kiritsugusioe-max/component-identifier-circuit-with-capacitance-measurement/image/Circuit.jpeg

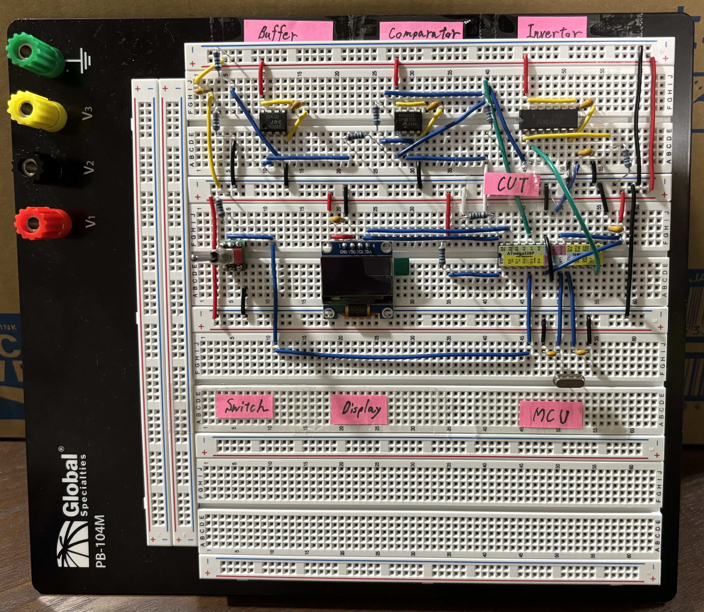
image/Circuit.jpeg
