kiritsugusioe-max/component-identifier-circuit-with-capacitance-measurement/data/Section4.1_4.2_Measurement_Data.xlsx

OPEN |  |  |  |  |  |  | Resistor | R=10kΩ |  |  |  |  |  | Resistor | R=4.7kΩ |  |  |  |  |  | Resistor | R=1kΩ
Buffer Output Voltage |  |  |  |  |  |  | Buffer Output Voltage |  |  |  |  |  |  | Buffer Output Voltage |  |  |  |  |  |  | Buffer Output Voltage
 | 1st | 2nd | 3rd | 4th | 5th | Ave |  | 1st | 2nd | 3rd | 4th | 5th | Ave |  | 1st | 2nd | 3rd | 4th | 5th | Ave |  | 1st | 2nd | 3rd | 4th | 5th | Ave
Max | 3.02 | 3.02 | 3.02 | 3.04 | 3.04 | 3.03 | Max | 3.04 | 3.02 | 3.02 | 3.02 | 3.02 | 3.02 | Max | 3.04 | 3.04 | 3.04 | 3.04 | 3.04 | 3.04 | Max | 3.03 | 3.03 | 3.03 | 3.03 | 3.03 | 3.03
Min | 2.96 | 2.96 | 2.96 | 2.92 | 2.94 | 2.95 | Min | 2.94 | 2.96 | 2.96 | 2.96 | 2.96 | 2.96 | Min | 2.8 | 2.8 | 2.8 | 2.8 | 2.8 | 2.8 | Min | 2.79 | 2.87 | 2.79 | 2.79 | 2.79 | 2.81
Ave | 2.98 | 2.98 | 2.98 | 2.98 | 2.98 | 2.98 | Ave | 2.99 | 2.99 | 2.99 | 2.99 | 2.99 | 2.99 | Ave | 2.92 | 2.92 | 2.92 | 2.92 | 2.92 | 2.92 | Ave | 2.94 | 2.94 | 2.94 | 2.94 | 2.94 | 2.94
(V) |  |  |  |  |  |  | (V) |  |  |  |  |  |  | (V) |  |  |  |  |  |  | (V)
V+ |  |  |  |  |  |  | V+ |  |  |  |  |  |  | V+ |  |  |  |  |  |  | V+
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
