kiritsugusioe-max/component-identifier-circuit-with-capacitance-measurement/data/Section4.3_Measurement_Data.xlsx

C=10nF |  |  |  |  |  |  |  |  |  |  |  |  |  |  |  |  |  |  |  |  | Circuit-Level Measurement |  |  |  |  |  |  | Circuit-Level Measurement
1st Trial |  |  |  |  |  |  | 2nd Trial |  |  |  |  |  |  | 3rd Trial |  |  |  |  |  |  | 10 nF Capacitance Measurement Summary |  |  |  |  |  |  | Capacitance Measurement Summary for Determining K
Measured Capacitance |  |  |  |  |  |  | Measured Capacitance |  |  |  |  |  |  | Measured Capacitance |  |  |  |  |  |  | Trial | Comparator Output Voltage VH |  | Comparator Output Voltage VL |  | VT+ at V- | VT- at V- | Comparator Output Voltage VH |  | Comparator Output Voltage VL |  | VT+ at V- | VT- at V-
 | 1st | 2nd | 3rd | 4th | 5th | Ave |  | 1st | 2nd | 3rd | 4th | 5th | Ave |  | 1st | 2nd | 3rd | 4th | 5th | Ave | 1 |  | 4.936 |  | 0.015 | 3.97 | 1.48 |  | 4.94 |  | 0.019 | 3.99 | 1.46
C | 10.97 | 11.16 | 11.1 | 10.73 | 11.04 | 11 | C | 10.89 | 10.9 | 10.81 | 10.8 | 10.76 | 10.83 | C | 10.85 | 10.79 | 10.98 | 10.73 | 10.65 | 10.8 | 2 |  | 4.94 |  | 0.012 | 3.98 | 1.48 |  | (V) |  | (V) | (V) | (V)
(nF) |  |  |  |  |  |  | (nF) |  |  |  |  |  |  | (nF) |  |  |  |  |  |  | 3 |  | 4.94 |  | 0.011 | 3.98 | 1.48
 |  |  |  |  |  |  |  |  |  |  |  |  |  |  |  |  |  |  |  |  | Average |  | 4.939 |  | 0.01267 | 3.977 | 1.48
Measured Resistance |  |  |  |  |  |  | Measured Resistance |  |  |  |  |  |  | Measured Resistance |  |  |  |  |  |  | Unit |  | (V) |  | (V) | (V) | (V)
 | 1st | 2nd | 3rd | 4th | 5th | Ave |  | 1st | 2nd | 3rd | 4th | 5th | Ave |  | 1st | 2nd | 3rd | 4th | 5th | Ave
R | 9.985 | 9.985 | 9.985 | 9.985 | 9.985 | 9.985 | R | 9.985 | 9.985 | 9.985 | 9.985 | 9.985 | 9.985 | R | 9.986 | 9.985 | 9.985 | 9.985 | 9.985 | 9.985
(kΩ) |  |  |  |  |  |  | (kΩ) |  |  |  |  |  |  | (kΩ)
Comparator Output Voltage |  |  |  |  |  |  | Comparator Output Voltage |  |  |  |  |  |  | Comparator Output Voltage
 | 1st | 2nd | 3rd | 4th | 5th | Ave |  | 1st | 2nd | 3rd | 4th | 5th | Ave |  | 1st | 2nd | 3rd | 4th | 5th | Ave
V_HIGH | 4.93 | 4.94 | 4.94 | 4.94 | 4.93 | 4.936 | V_HIGH | 4.94 | 4.94 | 4.94 | 4.94 | 4.94 | 4.94 | V_HIGH | 4.94 | 4.94 | 4.94 | 4.94 | 4.94 | 4.94
V_LOW | 0.014 | 0.016 | 0.016 | 0.015 | 0.015 | 0.015 | V_LOW | 0.013 | 0.011 | 0.012 | 0.012 | 0.012 | 0.012 | V_LOW | 0.011 | 0.011 | 0.011 | 0.011 | 0.01 | 0.011
(V) |  |  |  |  |  |  | (V) |  |  |  |  |  |  | (V)
V+ |  |  |  |  |  |  | V+ |  |  |  |  |  |  | V+
 | 1st | 2nd | 3rd | 4th | 5th | Ave |  | 1st | 2nd | 3rd | 4th | 5th | Ave |  | 1st | 2nd | 3rd | 4th | 5th | Ave
Threshold_H | 3.95 | 3.95 | 3.96 | 3.95 | 3.95 | 3.952 | Threshold_H | 3.96 | 3.96 | 3.96 | 3.96 | 3.96 | 3.96 | Threshold_H | 3.96 | 3.96 | 3.96 | 3.96 | 3.96 | 3.96
Threshold_L | 1.5 | 1.5 | 1.5 | 1.5 | 1.5 | 1.5 | Threshold_L | 1.5 | 1.5 | 1.5 | 1.5 | 1.5 | 1.5 | Threshold_L | 1.5 | 1.5 | 1.5 | 1.5 | 1.5 | 1.5
(V) |  |  |  |  |  |  | (V) |  |  |  |  |  |  | (V)
V- |  |  |  |  |  |  | V- |  |  |  |  |  |  | V-
 | 1st | 2nd | 3rd | 4th | 5th | Ave |  | 1st | 2nd | 3rd | 4th | 5th | Ave |  | 1st | 2nd | 3rd | 4th | 5th | Ave
Threshold_H | 3.97 | 3.97 | 3.97 | 3.97 | 3.97 | 3.97 | Threshold_H | 3.98 | 3.98 | 3.98 | 3.98 | 3.98 | 3.98 | Threshold_H | 3.98 | 3.98 | 3.98 | 3.98 | 3.98 | 3.98
Threshold_L | 1.48 | 1.48 | 1.48 | 1.48 | 1.48 | 1.48 | Threshold_L | 1.48 | 1.48 | 1.48 | 1.48 | 1.48 | 1.48 | Threshold_L | 1.48 | 1.49 | 1.48 | 1.48 | 1.49 | 1.48
(V) |  |  |  |  |  |  | (V) |  |  |  |  |  |  | (V)
Recalculated Period & Capacitance (based on measured values) |  |  |  |  |  |  | Recalculated Period & Capacitance (based on measured values) |  |  |  |  |  |  | Recalculated Period & Capacitance (based on measured values)
T_calibrated | 249 | (us) |  |  |  |  | T_calibrated | 246 | (us) |  |  |  |  | T_calibrated | 245 | (us)
C_calibrated | 10.8 | (nF) |  |  |  |  | C_calibrated | 10.83 | (nF) |  |  |  |  | C_calibrated | 11 | (nF)
C=4.7nF |  |  |  |  |  |  |  |  |  |  |  |  |  |  |  |  |  |  |  |  | Circuit-Level Measurement
1st Trial |  |  |  |  |  |  | 2nd Trial |  |  |  |  |  |  | 3rd Trial |  |  |  |  |  |  | 4.7nF Capacitance Measurement Summary
Measured Capacitance |  |  |  |  |  |  | Measured Capacitance |  |  |  |  |  |  | Measured Capacitance |  |  |  |  |  |  | Trial | Comparator Output Voltage VH |  | Comparator Output Voltage VL |  | VT+ at V- | VT- at V-
 | 1st | 2nd | 3rd | 4th | 5th | Ave |  | 1st | 2nd | 3rd | 4th | 5th | Ave |  | 1st | 2nd | 3rd | 4th | 5th | Ave | 1 |  | 4.938 |  | 0.019 | 3.98 | 1.476
C | 4.561 | 4.574 | 4.588 | 4.579 | 4.577 | 4.5758 | C | 4.601 | 4.639 | 4.653 | 4.657 | 4.653 | 4.6406 | C | 4.592 | 4.594 | 4.607 | 4.624 | 4.612 | 4.6058 | 2 |  | 4.92 |  | 0.021 | 3.98 | 1.47
(nF) |  |  |  |  |  |  | (nF) |  |  |  |  |  |  | (nF) |  |  |  |  |  |  | 3 |  | 4.94 |  | 0.018 | 3.98 | 1.47
 |  |  |  |  |  |  |  |  |  |  |  |  |  |  |  |  |  |  |  |  | Average |  | 4.933 |  | 0.01933 | 3.98 | 1.472
Measured Resistance |  |  |  |  |  |  | Measured Resistance |  |  |  |  |  |  | Measured Resistance |  |  |  |  |  |  | Unit |  | (V) |  | (V) | (V) | (V)
 | 1st | 2nd | 3rd | 4th | 5th | Ave |  | 1st | 2nd | 3rd | 4th | 5th | Ave |  | 1st | 2nd | 3rd | 4th | 5th | Ave
R | 9.985 | 9.985 | 9.985 | 9.985 | 9.985 | 9.985 | R | 9.985 | 9.985 | 9.985 | 9.985 | 9.985 | 9.985 | R | 9.985 | 9.985 | 9.985 | 9.985 | 9.985 | 9.985
(kΩ) |  |  |  |  |  |  | (kΩ) |  |  |  |  |  |  | (kΩ)
Comparator Output Voltage |  |  |  |  |  |  | Comparator Output Voltage |  |  |  |  |  |  | Comparator Output Voltage
 | 1st | 2nd | 3rd | 4th | 5th | Ave |  | 1st | 2nd | 3rd | 4th | 5th | Ave |  | 1st | 2nd | 3rd | 4th | 5th | Ave
V_HIGH | 4.94 | 4.93 | 4.94 | 4.94 | 4.94 | 4.938 | V_HIGH | 4.92 | 4.92 | 4.92 | 4.92 | 4.92 | 4.92 | V_HIGH | 4.94 | 4.94 | 4.94 | 4.94 | 4.94 | 4.94
V_LOW | 0.02 | 0.02 | 0.019 | 0.017 | 0.018 | 0.019 | V_LOW | 0.021 | 0.019 | 0.02 | 0.022 | 0.021 | 0.021 | V_LOW | 0.019 | 0.018 | 0.018 | 0.019 | 0.018 | 0.018
(V) |  |  |  |  |  |  | (V) |  |  |  |  |  |  | (V)
V+ |  |  |  |  |  |  | V+ |  |  |  |  |  |  | V+
 | 1st | 2nd | 3rd | 4th | 5th | Ave |  | 1st | 2nd | 3rd | 4th | 5th | Ave |  | 1st | 2nd | 3rd | 4th | 5th | Ave
Threshold_H | 3.96 | 3.96 | 3.96 | 3.96 | 3.96 | 3.96 | Threshold_H | 3.95 | 3.95 | 3.95 | 3.95 | 3.95 | 3.95 | Threshold_H | 3.95 | 3.96 | 3.95 | 3.95 | 3.96 | 3.954
Threshold_L | 1.5 | 1.5 | 1.5 | 1.5 | 1.5 | 1.5 | Threshold_L | 1.5 | 1.5 | 1.5 | 1.5 | 1.5 | 1.5 | Threshold_L | 1.5 | 1.5 | 1.5 | 1.5 | 1.5 | 1.5
(V) |  |  |  |  |  |  | (V) |  |  |  |  |  |  | (V)
V- |  |  |  |  |  |  | V- |  |  |  |  |  |  | V-
 | 1st | 2nd | 3rd | 4th | 5th | Ave |  | 1st | 2nd | 3rd | 4th | 5th | Ave |  | 1st | 2nd | 3rd | 4th | 5th | Ave
Threshold_H | 3.98 | 3.98 | 3.98 | 3.98 | 3.98 | 3.98 | Threshold_H | 3.98 | 3.98 | 3.98 | 3.98 | 3.98 | 3.98 | Threshold_H | 3.98 | 3.98 | 3.98 | 3.98 | 3.98 | 3.98
Threshold_L | 1.47 | 1.47 | 1.48 | 1.48 | 1.48 | 1.476 | Threshold_L | 1.47 | 1.47 | 1.47 | 1.47 | 1.47 | 1.47 | Threshold_L | 1.47 | 1.47 | 1.47 | 1.47 | 1.47 | 1.47
(V) |  |  |  |  |  |  | (V) |  |  |  |  |  |  | (V)
Recalculated Period & Capacitance (based on measured values) |  |  |  |  |  |  | Recalculated Period & Capacitance (based on measured values) |  |  |  |  |  |  | Recalculated Period & Capacitance (based on measured values)
T_calibrated | 104 | (us) |  |  |  |  | T_calibrated | 107 | (us) |  |  |  |  | T_calibrated | 105 | (us)
C_calibrated | 4.58 | (nF) |  |  |  |  | C_calibrated | 4.64 | (nF) |  |  |  |  | C_calibrated | 4.61 | (nF)
C=2.2nF |  |  |  |  |  |  |  |  |  |  |  |  |  |  |  |  |  |  |  |  | Circuit-Level Measurement
1st Trial |  |  |  |  |  |  | 2nd Trial |  |  |  |  |  |  | 3rd Trial |  |  |  |  |  |  | 2.2nF Capacitance Measurement Summary
Measured Capacitance |  |  |  |  |  |  | Measured Capacitance |  |  |  |  |  |  | Measured Capacitance |  |  |  |  |  |  | Trial | Comparator Output Voltage VH |  | Comparator Output Voltage VL |  | VT+ at V- | VT- at V-
 | 1st | 2nd | 3rd | 4th | 5th | Ave |  | 1st | 2nd | 3rd | 4th | 5th | Ave |  | 1st | 2nd | 3rd | 4th | 5th | Ave | 1 |  | 4.93 |  | 0.028 | 3.99 | 1.46
C | 2.072 | 2.069 | 2.07 | 2.072 | 2.075 | 2.0716 | C | 2.064 | 2.068 | 2.072 | 2.078 | 2.074 | 2.0712 | C | 2.077 | 2.078 | 2.076 | 2.074 | 2.074 | 2.0758 | 2 |  | 4.934 |  | 0.024 | 3.99 | 1.46
(nF) |  |  |  |  |  |  | (nF) |  |  |  |  |  |  | (nF) |  |  |  |  |  |  | 3 |  | 4.94 |  | 0.0202 | 4 | 1.46
 |  |  |  |  |  |  |  |  |  |  |  |  |  |  |  |  |  |  |  |  | Average |  | 4.935 |  | 0.02407 | 3.993 | 1.46
Measured Resistance |  |  |  |  |  |  | Measured Resistance |  |  |  |  |  |  | Measured Resistance |  |  |  |  |  |  | Unit |  | (V) |  | (V) | (V) | (V)
 | 1st | 2nd | 3rd | 4th | 5th | Ave |  | 1st | 2nd | 3rd | 4th | 5th | Ave |  | 1st | 2nd | 3rd | 4th | 5th | Ave
R | 9.985 | 9.985 | 9.985 | 9.985 | 9.985 | 9.985 | R | 9.985 | 9.985 | 9.985 | 9.985 | 9.985 | 9.985 | R | 9.985 | 9.985 | 9.985 | 9.985 | 9.985 | 9.985
(kΩ) |  |  |  |  |  |  | (kΩ) |  |  |  |  |  |  | (kΩ)
Comparator Output Voltage |  |  |  |  |  |  | Comparator Output Voltage |  |  |  |  |  |  | Comparator Output Voltage
 | 1st | 2nd | 3rd | 4th | 5th | Ave |  | 1st | 2nd | 3rd | 4th | 5th | Ave |  | 1st | 2nd | 3rd | 4th | 5th | Ave
V_HIGH | 4.93 | 4.93 | 4.93 | 4.93 | 4.93 | 4.93 | V_HIGH | 4.94 | 4.94 | 4.93 | 4.93 | 4.93 | 4.934 | V_HIGH | 4.94 | 4.94 | 4.94 | 4.94 | 4.94 | 4.94
V_LOW | 0.028 | 0.028 | 0.028 | 0.028 | 0.027 | 0.028 | V_LOW | 0.025 | 0.024 | 0.024 | 0.024 | 0.023 | 0.024 | V_LOW | 0.019 | 0.019 | 0.019 | 0.023 | 0.021 | 0.02
(V) |  |  |  |  |  |  | (V) |  |  |  |  |  |  | (V)
V+ |  |  |  |  |  |  | V+ |  |  |  |  |  |  | V+
 | 1st | 2nd | 3rd | 4th | 5th | Ave |  | 1st | 2nd | 3rd | 4th | 5th | Ave |  | 1st | 2nd | 3rd | 4th | 5th | Ave
Threshold_H | 3.95 | 3.95 | 3.95 | 3.95 | 3.95 | 3.95 | Threshold_H | 3.96 | 3.96 | 3.96 | 3.96 | 3.96 | 3.96 | Threshold_H | 3.95 | 3.95 | 3.95 | 3.95 | 3.95 | 3.95
Threshold_L | 1.5 | 1.5 | 1.5 | 1.5 | 1.5 | 1.5 | Threshold_L | 1.5 | 1.5 | 1.5 | 1.5 | 1.5 | 1.5 | Threshold_L | 1.5 | 1.5 | 1.5 | 1.5 | 1.5 | 1.5
(V) |  |  |  |  |  |  | (V) |  |  |  |  |  |  | (V)
V- |  |  |  |  |  |  | V- |  |  |  |  |  |  | V-
 | 1st | 2nd | 3rd | 4th | 5th | Ave |  | 1st | 2nd | 3rd | 4th | 5th | Ave |  | 1st | 2nd | 3rd | 4th | 5th | Ave
Threshold_H | 3.99 | 3.99 | 3.99 | 3.99 | 3.99 | 3.99 | Threshold_H | 3.99 | 3.99 | 3.99 | 3.99 | 3.99 | 3.99 | Threshold_H | 4 | 4 | 4 | 4 | 4 | 4
Threshold_L | 1.46 | 1.46 | 1.46 | 1.46 | 1.46 | 1.46 | Threshold_L | 1.46 | 1.46 | 1.46 | 1.46 | 1.46 | 1.46 | Threshold_L | 1.46 | 1.46 | 1.46 | 1.46 | 1.46 | 1.46
(V) |  |  |  |  |  |  | (V) |  |  |  |  |  |  | (V)
Recalculated Period & Capacitance (based on measured values) |  |  |  |  |  |  | Recalculated Period & Capacitance (based on measured values) |  |  |  |  |  |  | Recalculated Period & Capacitance (based on measured values)
T_calibrated | 48.07 | (us) |  |  |  |  | T_calibrated | 47.96 | (us) |  |  |  |  | T_calibrated | 48.2 | (us)
C_calibrated | 2.09 | (nF) |  |  |  |  | C_calibrated | 2.07 | (nF) |  |  |  |  | C_calibrated | 2.08 | (nF)
C=1nF |  |  |  |  |  |  |  |  |  |  |  |  |  |  |  |  |  |  |  |  | Circuit-Level Measurement
1st Trial |  |  |  |  |  |  | 2nd Trial |  |  |  |  |  |  | 3rd Trial |  |  |  |  |  |  | 1nF Capacitance Measurement Summary
Measured Capacitance |  |  |  |  |  |  | Measured Capacitance |  |  |  |  |  |  | Measured Capacitance |  |  |  |  |  |  | Trial | Comparator Output Voltage VH |  | Comparator Output Voltage VL |  | VT+ at V- | VT- at V-
 | 1st | 2nd | 3rd | 4th | 5th | Ave |  | 1st | 2nd | 3rd | 4th | 5th | Ave |  | 1st | 2nd | 3rd | 4th | 5th | Ave | 1 |  | 4.93 |  | 0.023 | 4.01 | 1.44
C | 1.022 | 1.02 | 1.019 | 1.022 | 1.022 | 1.021 | C | 1.023 | 1.026 | 1.025 | 1.025 | 1.028 | 1.0254 | C | 1.027 | 1.027 | 1.026 | 1.025 | 1.025 | 1.026 | 2 |  | 4.946 |  | 0.027 | 4.01 | 1.44
(nF) |  |  |  |  |  |  | (nF) |  |  |  |  |  |  | (nF) |  |  |  |  |  |  | 3 |  | 4.94 |  | 0.033 | 4.01 | 1.44
 |  |  |  |  |  |  |  |  |  |  |  |  |  |  |  |  |  |  |  |  | Average |  | 4.939 |  | 0.02767 | 4.01 | 1.44
Measured Resistance |  |  |  |  |  |  | Measured Resistance |  |  |  |  |  |  | Measured Resistance |  |  |  |  |  |  | Unit |  | (V) |  | (V) | (V) | (V)
 | 1st | 2nd | 3rd | 4th | 5th | Ave |  | 1st | 2nd | 3rd | 4th | 5th | Ave |  | 1st | 2nd | 3rd | 4th | 5th | Ave
R | 9.985 | 9.985 | 9.985 | 9.985 | 9.985 | 9.985 | R | 9.985 | 9.985 | 9.985 | 9.985 | 9.985 | 9.985 | R | 9.985 | 9.985 | 9.985 | 9.985 | 9.985 | 9.985
(kΩ) |  |  |  |  |  |  | (kΩ) |  |  |  |  |  |  | (kΩ)
Comparator Output Voltage |  |  |  |  |  |  | Comparator Output Voltage |  |  |  |  |  |  | Comparator Output Voltage
 | 1st | 2nd | 3rd | 4th | 5th | Ave |  | 1st | 2nd | 3rd | 4th | 5th | Ave |  | 1st | 2nd | 3rd | 4th | 5th | Ave
V_HIGH | 4.93 | 4.93 | 4.93 | 4.93 | 4.93 | 4.93 | V_HIGH | 4.94 | 4.94 | 4.95 | 4.95 | 4.95 | 4.946 | V_HIGH | 4.94 | 4.94 | 4.94 | 4.94 | 4.94 | 4.94
V_LOW | 0.023 | 0.024 | 0.023 | 0.023 | 0.024 | 0.023 | V_LOW | 0.026 | 0.026 | 0.028 | 0.027 | 0.027 | 0.027 | V_LOW | 0.033 | 0.033 | 0.034 | 0.033 | 0.034 | 0.033
(V) |  |  |  |  |  |  | (V) |  |  |  |  |  |  | (V)
V+ |  |  |  |  |  |  | V+ |  |  |  |  |  |  | V+
 | 1st | 2nd | 3rd | 4th | 5th | Ave |  | 1st | 2nd | 3rd | 4th | 5th | Ave |  | 1st | 2nd | 3rd | 4th | 5th | Ave
Threshold_H | 3.95 | 3.95 | 3.95 | 3.95 | 3.95 | 3.95 | Threshold_H | 3.95 | 3.95 | 3.95 | 3.95 | 3.95 | 3.95 | Threshold_H | 3.96 | 3.96 | 3.96 | 3.96 | 3.96 | 3.96
Threshold_L | 1.5 | 1.5 | 1.5 | 1.5 | 1.5 | 1.5 | Threshold_L | 1.5 | 1.5 | 1.5 | 1.5 | 1.5 | 1.5 | Threshold_L | 1.5 | 1.5 | 1.5 | 1.5 | 1.5 | 1.5
(V) |  |  |  |  |  |  | (V) |  |  |  |  |  |  | (V)
V- |  |  |  |  |  |  | V- |  |  |  |  |  |  | V-
 | 1st | 2nd | 3rd | 4th | 5th | Ave |  | 1st | 2nd | 3rd | 4th | 5th | Ave |  | 1st | 2nd | 3rd | 4th | 5th | Ave
Threshold_H | 4.01 | 4.01 | 4.01 | 4.01 | 4.01 | 4.01 | Threshold_H | 4.01 | 4.01 | 4.01 | 4.01 | 4.01 | 4.01 | Threshold_H | 4.01 | 4.01 | 4.01 | 4.01 | 4.01 | 4.01
Threshold_L | 1.44 | 1.44 | 1.44 | 1.44 | 1.44 | 1.44 | Threshold_L | 1.44 | 1.44 | 1.44 | 1.44 | 1.44 | 1.44 | Threshold_L | 1.44 | 1.44 | 1.44 | 1.44 | 1.44 | 1.44
(V) |  |  |  |  |  |  | (V) |  |  |  |  |  |  | (V)
Recalculated Period & Capacitance (based on measured values) |  |  |  |  |  |  | Recalculated Period & Capacitance (based on measured values) |  |  |  |  |  |  | Recalculated Period & Capacitance (based on measured values)
T_calibrated | 24.14 | (us) |  |  |  |  | T_calibrated | 24.13 | (us) |  |  |  |  | T_calibrated | 24.22 | (us)
C_calibrated | 1.02 | (nF) |  |  |  |  | C_calibrated | 1.03 | (nF) |  |  |  |  | C_calibrated | 1.03 | (nF)
