kiritsugusioe-max/component-identifier-circuit-with-capacitance-measurement/data/Section_6.1_Measurement_Data.xlsx

Display Result of Resistor |  |  |  |  |  |  |  | Display Result of Open |  |  |  |  |  |  |  | System-Level Measurement
R=10kΩ |  |  |  |  |  |  |  | OPEN |  |  |  |  |  |  |  | 1nF System Measurement Results
 | 1st | 2nd | 3rd | 4th | 5th | Ave |  |  | 1st | 2nd | 3rd | 4th | 5th | Ave |  |  | 1st | 2nd | 3rd | 4th | 5th | Ave
Judge | Resistor | Resistor | Resistor | Resistor | Resistor |  |  | Judge | OPEN | OPEN | OPEN | OPEN | OPEN |  |  | Display_C | 1.03 | 1.04 | 1.04 | 1.04 | 1.04 | 1.04 | (nF)
Voltage | 4.92 | 4.92 | 4.92 | 4.92 | 4.92 | 4.92 | (V) | Voltage | 2.959 | 2.959 | 2.959 | 2.958 | 2.958 | 2.959 | (V) | Display_T | 23.94 | 23.94 | 23.94 | 23.94 | 23.94 | 23.94 | (us)
 |  |  |  |  |  |  |  |  |  |  |  |  |  |  |  | Measured_T | 23.96 | 23.96 | 23.82 | 23.91 | 23.94 | 23.92 | (us)
R=4.7kΩ
 | 1st | 2nd | 3rd | 4th | 5th | Ave
Judge | Resistor | Resistor | Resistor | Resistor | Resistor |  |  |  |  |  |  |  |  |  |  | System-Level Measurement
Voltage | 4.92 | 4.917 | 4.92 | 4.917 | 4.917 | 4.918 | (V) |  |  |  |  |  |  |  |  | 2.2nF System Measurement Results
 |  |  |  |  |  |  |  |  |  |  |  |  |  |  |  |  | 1st | 2nd | 3rd | 4th | 5th | Ave
R=2.2kΩ |  |  |  |  |  |  |  |  |  |  |  |  |  |  |  | Display_C | 2.08 | 2.05 | 2.04 | 2.04 | 2.04 | 2.05 | (nF)
 | 1st | 2nd | 3rd | 4th | 5th | Ave |  |  |  |  |  |  |  |  |  | Display_T | 47.99 | 47.25 | 47.13 | 47.13 | 47.13 | 47.33 | (us)
Judge | Resistor | Resistor | Resistor | Resistor | Resistor |  |  |  |  |  |  |  |  |  |  | Measured_T | 47.3 | 47.17 | 47.07 | 47.1 | 47.08 | 47.14 | (us)
Voltage | 4.916 | 4.916 | 4.916 | 4.916 | 4.916 | 4.916 | (V)
R=1kΩ |  |  |  |  |  |  |  |  |  |  |  |  |  |  |  | System-Level Measurement
 | 1st | 2nd | 3rd | 4th | 5th | Ave |  |  |  |  |  |  |  |  |  | 4.7nF System Measurement Results
Judge | Resistor | Resistor | Resistor | Resistor | Resistor |  |  |  |  |  |  |  |  |  |  |  | 1st | 2nd | 3rd | 4th | 5th | Ave
Voltage | 4.916 | 4.916 | 4.916 | 4.916 | 4.916 | 4.916 | (V) |  |  |  |  |  |  |  |  | Display_C | 4.46 | 4.45 | 4.44 | 4.44 | 4.44 | 4.45 | (nF)
 |  |  |  |  |  |  |  |  |  |  |  |  |  |  |  | Display_T | 103 | 102.64 | 102.56 | 102.5 | 102.5 | 102.64 | (us)
 |  |  |  |  |  |  |  |  |  |  |  |  |  |  |  | Measured_T | 102.77 | 102.51 | 102.67 | 102.48 | 102.41 | 102.57 | (us)
Display Result of Resistor (Extended version)
R=220Ω |  |  |  |  |  |  |  |  |  |  |  |  |  |  |  | System-Level Measurement
 | 1st | 2nd | 3rd | 4th | 5th | Ave |  |  |  |  |  |  |  |  |  | 10nF System Measurement Results
Judge | Resistor | Resistor | Resistor | Resistor | Resistor |  |  |  |  |  |  |  |  |  |  |  | 1st | 2nd | 3rd | 4th | 5th | Ave
Voltage | 4.916 | 4.916 | 4.916 | 4.916 | 4.916 | 4.916 | (V) |  |  |  |  |  |  |  |  | Display_C | 11.22 | 11.2 | 11.21 | 11.19 | 11.24 | 11.21 | (nF)
 |  |  |  |  |  |  |  |  |  |  |  |  |  |  |  | Display_T | 259.13 | 258.44 | 258.69 | 258.32 | 259.56 | 258.83 | (us)
R=470Ω |  |  |  |  |  |  |  |  |  |  |  |  |  |  |  | Measured_T | 258.92 | 258.78 | 258.35 | 258.16 | 259.42 | 258.73 | (us)
 | 1st | 2nd | 3rd | 4th | 5th | Ave
Judge | Resistor | Resistor | Resistor | Resistor | Resistor
Voltage | 4.916 | 4.916 | 4.916 | 4.916 | 4.916 | 4.916 | (V)
R=1kΩ
 | 1st | 2nd | 3rd | 4th | 5th | Ave
Judge | Resistor | Resistor | Resistor | Resistor | Resistor
Voltage | 4.916 | 4.916 | 4.916 | 4.916 | 4.916 | 4.916 | (V)
R=2.2kΩ
 | 1st | 2nd | 3rd | 4th | 5th | Ave
Judge | Resistor | Resistor | Resistor | Resistor | Resistor
Voltage | 4.916 | 4.916 | 4.916 | 4.916 | 4.916 | 4.916 | (V)
R=4.7kΩ
 | 1st | 2nd | 3rd | 4th | 5th | Ave
Judge | Resistor | Resistor | Resistor | Resistor | Resistor
Voltage | 4.92 | 4.917 | 4.92 | 4.917 | 4.917 | 4.918 | (V)
R=10kΩ
 | 1st | 2nd | 3rd | 4th | 5th | Ave
Judge | Resistor | Resistor | Resistor | Resistor | Resistor
Voltage | 4.92 | 4.92 | 4.92 | 4.92 | 4.92 | 4.92 | (V)
R=22kΩ
 | 1st | 2nd | 3rd | 4th | 5th | Ave
Judge | Resistor | Resistor | Resistor | Resistor | Resistor
Voltage | 4.92 | 4.92 | 4.92 | 4.92 | 4.92 | 4.92 | (V)
R=33kΩ
 | 1st | 2nd | 3rd | 4th | 5th | Ave
Judge | Resistor | Resistor | Resistor | Resistor | Resistor
Voltage | 4.921 | 4.925 | 4.92 | 4.923 | 4.921 | 4.922 | (V)
R=47kΩ
 | 1st | 2nd | 3rd | 4th | 5th | Ave
Judge | Resistor | Resistor | Resistor | Resistor | Resistor
Voltage | 4.544 | 4.544 | 4.544 | 4.544 | 4.544 | 4.544 | (V)
