kiritsugusioe-max/component-identifier-circuit-with-capacitance-measurement/data/Section_6.2_Measurement_Data.xlsx

System-Level Measurement |  |  |  |  |  |  |  | System-Level Measurement |  |  |  |  |  |  |  | System-Level Measurement |  |  |  |  |  |  |  | System-Level Measurement
1nF System Measurement Results |  |  |  |  |  |  |  | 2.2nF System Measurement Results |  |  |  |  |  |  |  | 4.7nF System Measurement Results |  |  |  |  |  |  |  | 10nF System Measurement Results
 | 1st | 2nd | 3rd | 4th | 5th | Ave |  |  | 1st | 2nd | 3rd | 4th | 5th | Ave |  |  | 1st | 2nd | 3rd | 4th | 5th | Ave |  |  | 1st | 2nd | 3rd | 4th | 5th | Ave
Display_C | 1.03 | 1.04 | 1.04 | 1.04 | 1.04 | 1.04 | (nF) | Display_C | 2.08 | 2.05 | 2.04 | 2.04 | 2.04 | 2.05 | (nF) | Display_C | 4.46 | 4.45 | 4.44 | 4.44 | 4.44 | 4.45 | (nF) | Display_C | 11.22 | 11.2 | 11.21 | 11.19 | 11.24 | 11.21 | (nF)
Display_T | 23.94 | 23.94 | 23.94 | 23.94 | 23.94 | 23.94 | (us) | Display_T | 47.99 | 47.25 | 47.13 | 47.13 | 47.13 | 47.33 | (us) | Display_T | 103 | 102.64 | 102.56 | 102.5 | 102.5 | 102.64 | (us) | Display_T | 259.13 | 258.44 | 258.69 | 258.32 | 259.56 | 258.83 | (us)
Measured_T | 23.96 | 23.96 | 23.82 | 23.91 | 23.94 | 23.92 | (us) | Measured_T | 47.3 | 47.17 | 47.07 | 47.1 | 47.08 | 47.14 | (us) | Measured_T | 102.77 | 102.51 | 102.67 | 102.48 | 102.41 | 102.57 | (us) | Measured_T | 258.92 | 258.78 | 258.35 | 258.16 | 259.42 | 258.73 | (us)
1st Trial |  |  |  |  |  |  |  | 1st Trial |  |  |  |  |  |  |  | 1st Trial |  |  |  |  |  |  |  | 1st Trial
Measured Capacitance |  |  |  |  |  |  |  | Measured Capacitance |  |  |  |  |  |  |  | Measured Capacitance |  |  |  |  |  |  |  | Measured Capacitance
 | 1st | 2nd | 3rd | 4th | 5th | Ave |  |  | 1st | 2nd | 3rd | 4th | 5th | Ave |  |  | 1st | 2nd | 3rd | 4th | 5th | Ave |  |  | 1st | 2nd | 3rd | 4th | 5th | Ave
C | 1.022 | 1.02 | 1.019 | 1.022 | 1.022 | 1.021 |  | C | 2.072 | 2.069 | 2.07 | 2.072 | 2.075 | 2.0716 |  | C | 4.561 | 4.574 | 4.588 | 4.579 | 4.577 | 4.5758 |  | C | 10.97 | 11.16 | 11.1 | 10.73 | 11.04 | 11
(nF) |  |  |  |  |  |  |  | (nF) |  |  |  |  |  |  |  | (nF) |  |  |  |  |  |  |  | (nF)
2nd Trial |  |  |  |  |  |  |  | 2nd Trial |  |  |  |  |  |  |  | 2nd Trial |  |  |  |  |  |  |  | 2nd Trial
Measured Capacitance |  |  |  |  |  |  |  | Measured Capacitance |  |  |  |  |  |  |  | Measured Capacitance |  |  |  |  |  |  |  | Measured Capacitance
 | 1st | 2nd | 3rd | 4th | 5th | Ave |  |  | 1st | 2nd | 3rd | 4th | 5th | Ave |  |  | 1st | 2nd | 3rd | 4th | 5th | Ave |  |  | 1st | 2nd | 3rd | 4th | 5th | Ave
C | 1.023 | 1.026 | 1.025 | 1.025 | 1.028 | 1.0254 |  | C | 2.064 | 2.068 | 2.072 | 2.078 | 2.074 | 2.0712 |  | C | 4.601 | 4.639 | 4.653 | 4.657 | 4.653 | 4.6406 |  | C | 10.89 | 10.9 | 10.81 | 10.8 | 10.76 | 10.83
(nF) |  |  |  |  |  |  |  | (nF) |  |  |  |  |  |  |  | (nF) |  |  |  |  |  |  |  | (nF)
3rd Trial |  |  |  |  |  |  |  | 3rd Trial |  |  |  |  |  |  |  | 3rd Trial |  |  |  |  |  |  |  | 3rd Trial
Measured Capacitance |  |  |  |  |  |  |  | Measured Capacitance |  |  |  |  |  |  |  | Measured Capacitance |  |  |  |  |  |  |  | Measured Capacitance
 | 1st | 2nd | 3rd | 4th | 5th | Ave |  |  | 1st | 2nd | 3rd | 4th | 5th | Ave |  |  | 1st | 2nd | 3rd | 4th | 5th | Ave |  |  | 1st | 2nd | 3rd | 4th | 5th | Ave
C | 1.027 | 1.027 | 1.026 | 1.025 | 1.025 | 1.026 |  | C | 2.077 | 2.078 | 2.076 | 2.074 | 2.074 | 2.0758 |  | C | 4.592 | 4.594 | 4.607 | 4.624 | 4.612 | 4.6058 |  | C | 10.85 | 10.79 | 10.98 | 10.73 | 10.65 | 10.8
(nF) |  |  |  |  |  |  |  | (nF) |  |  |  |  |  |  |  | (nF) |  |  |  |  |  |  |  | (nF)
Summary |  |  |  |  |  |  |  | Summary |  |  |  |  |  |  |  | Summary |  |  |  |  |  |  |  | Summary
1nF Display Capacitane VS Measured Capacitance |  |  |  |  |  |  |  | 2.2 nF Display Capacitane VS Measured Capacitance |  |  |  |  |  |  |  | 4.7 nF Display Capacitane VS Measured Capacitance |  |  |  |  |  |  |  | 10 nF Display Capacitane VS Measured Capacitance
Measured C | 1.02 | (nF) |  |  |  |  |  | Measured C | 2.07 | (nF) |  |  |  |  |  | Measured C | 4.61 | (nF) |  |  |  |  |  | Measured C | 10.88 | (nF)
Displayed C | 1.04 | (nF) |  |  |  |  |  | Displayed C | 2.05 | (nF) |  |  |  |  |  | Displayed C | 4.45 | (nF) |  |  |  |  |  | Displayed C | 11.21 | (nF)
Error | 1.96 | (%) |  |  |  |  |  | Error | 0.97 | (%) |  |  |  |  |  | Error | 3.5 | (%) |  |  |  |  |  | Error | 3 | (%)
1nFDisplay Period VS Measured Period |  |  |  |  |  |  |  | 2.2 nF Display Period VS Measured Period |  |  |  |  |  |  |  | 4.7 nF Display Period VS Measured Period |  |  |  |  |  |  |  | 10 nF Display Period VS Measured Period
Measured T | 23.92 | (us) |  |  |  |  |  | Measured T | 47.14 | (us) |  |  |  |  |  | Measured T | 102.64 | (us) |  |  |  |  |  | Measured T | 258.73 | (us)
Displayed T | 23.94 | (us) |  |  |  |  |  | Displayed T | 47.33 | (us) |  |  |  |  |  | Displayed T | 102.57 | (us) |  |  |  |  |  | Displayed T | 258.83 | (us)
Error | 0.08 | (%) |  |  |  |  |  | Error | 0.4 | (%) |  |  |  |  |  | Error | 0.07 | (%) |  |  |  |  |  | Error | 0.04 | (%)
