kiritsugusioe-max/component-identifier-circuit-with-capacitance-measurement/schematic/Identifier_Circuit_Schematic.pdf

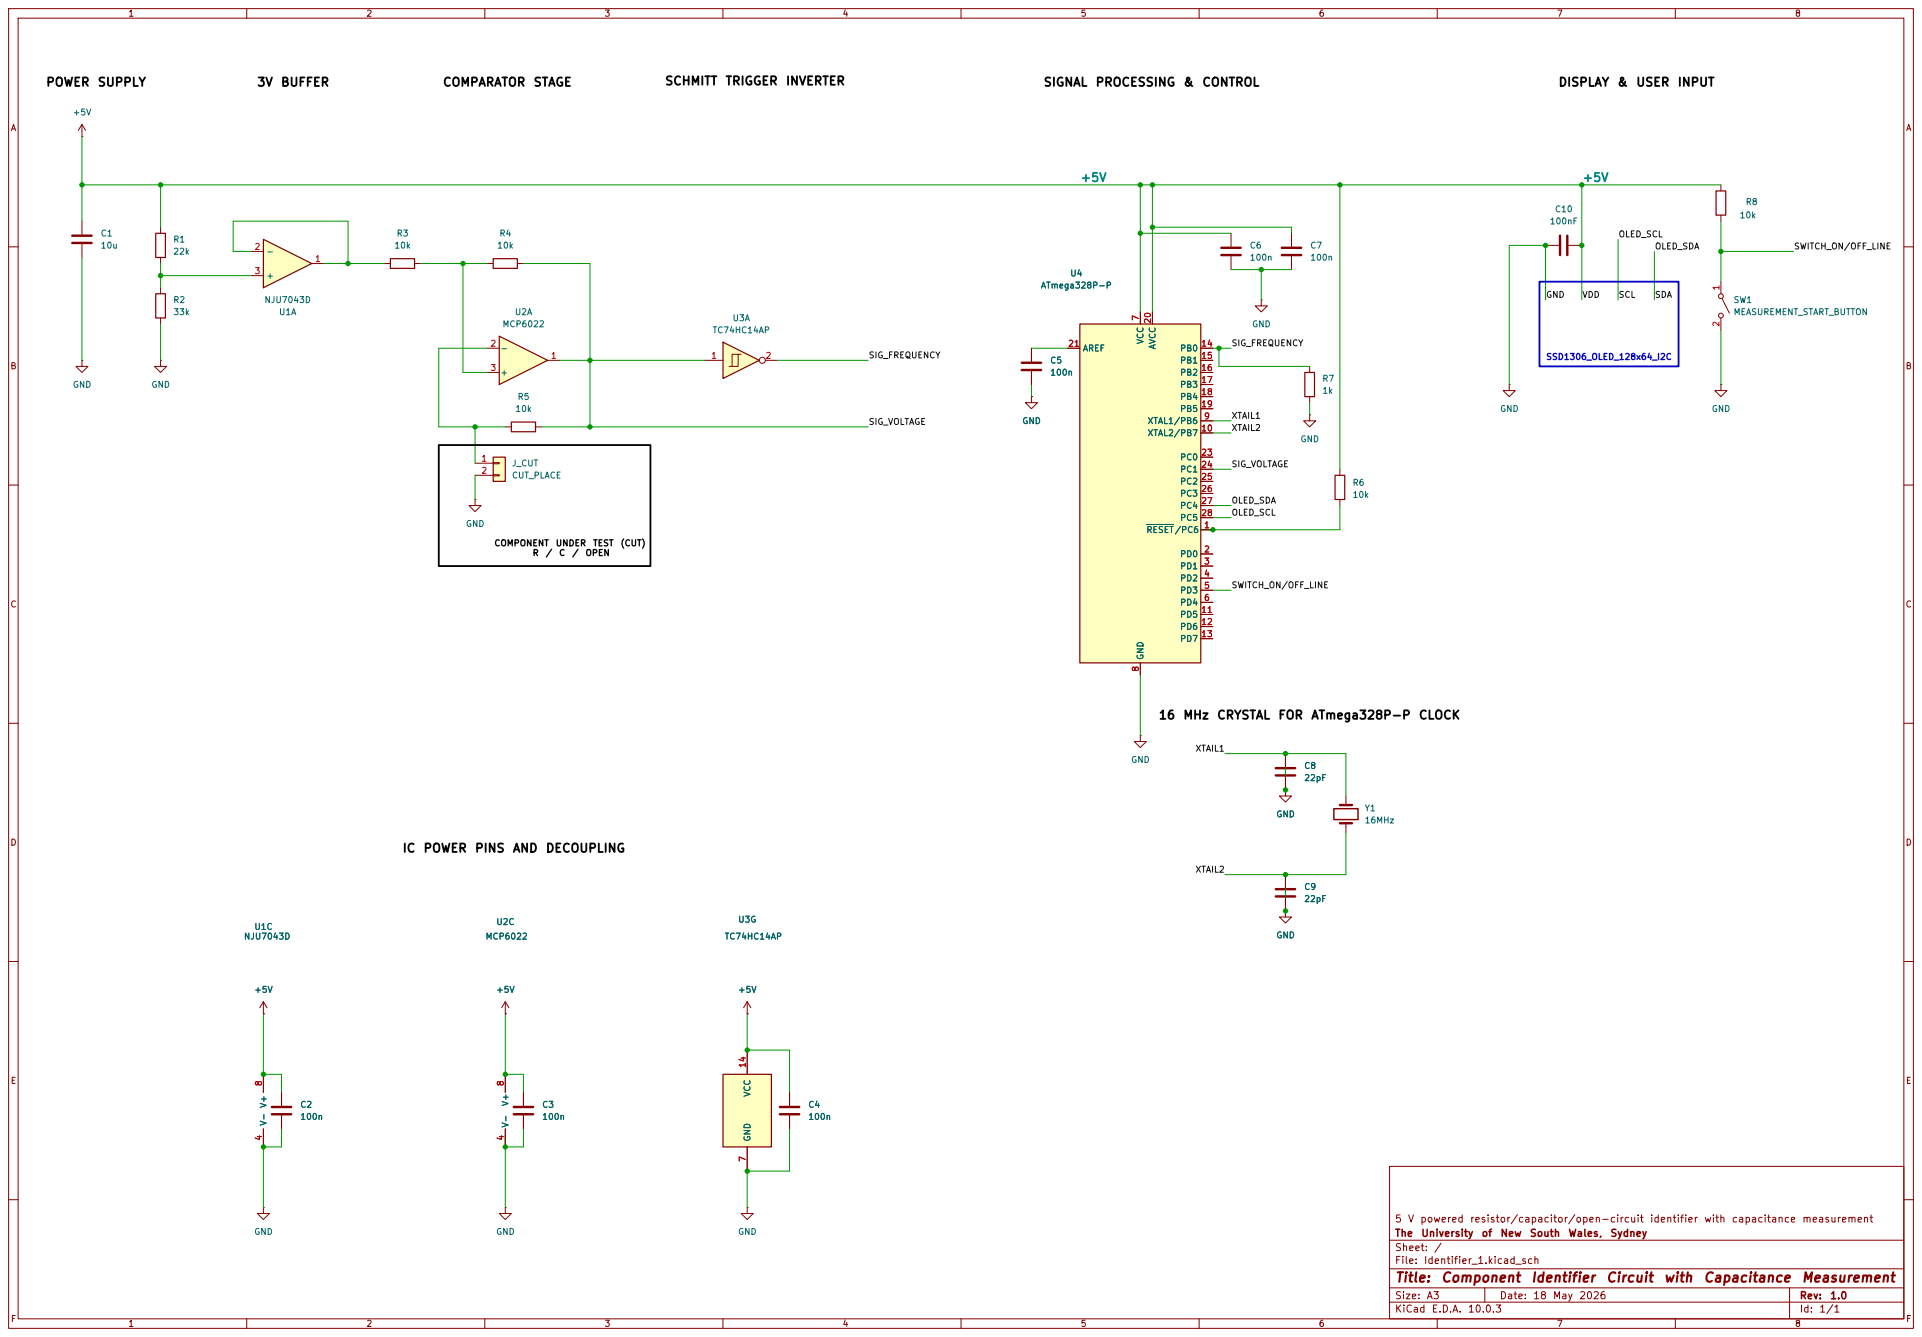
[picture p6: page 1]

IC POWER PINS AND DECOUPLING
100n U2C MCP6022 V-

5 V powered resistor/capacitor/open-circuit identifier with capacitance measurement
The University of New South Wales, Sydney
Sheet: /
File: Identifier_1.kicad_sch
Title: Component Identifier Circuit with Capacitance Measurement

Size: A3 | Rev: 1.0 | F Date: 18 May 2026
KiCad E.D.A. 10.0.3 | Id: 1/1
