kiritsugusioe-max/component-identifier-circuit-with-capacitance-measurement/simulation/Personal_Project_Identifier_Circuit/Identifier_C.asc

C1: cap; 10µ
C2: cap; 100n
C3: cap; 100n
C4: cap; 100n
C_CUT: cap; 10n
R1: res; 22k
R2: res; 33k
R3: res; 10k
R4: res; 10k
R5: res; 10k
U1: UniversalOpAmp3
U2: UniversalOpAmp2
U4: SN74HC14
V1: voltage; 5
Named nets: 0, SIG_Frequency, SIG_Voltage
.tran 20ms
Power Supply
Buffer
Comparator
Schmitt trriger inverter
CUT
Signals to ATmega328P
